tdaede/toshiba-64mbit-adapter/toshiba-64mbit-adapter.pdf

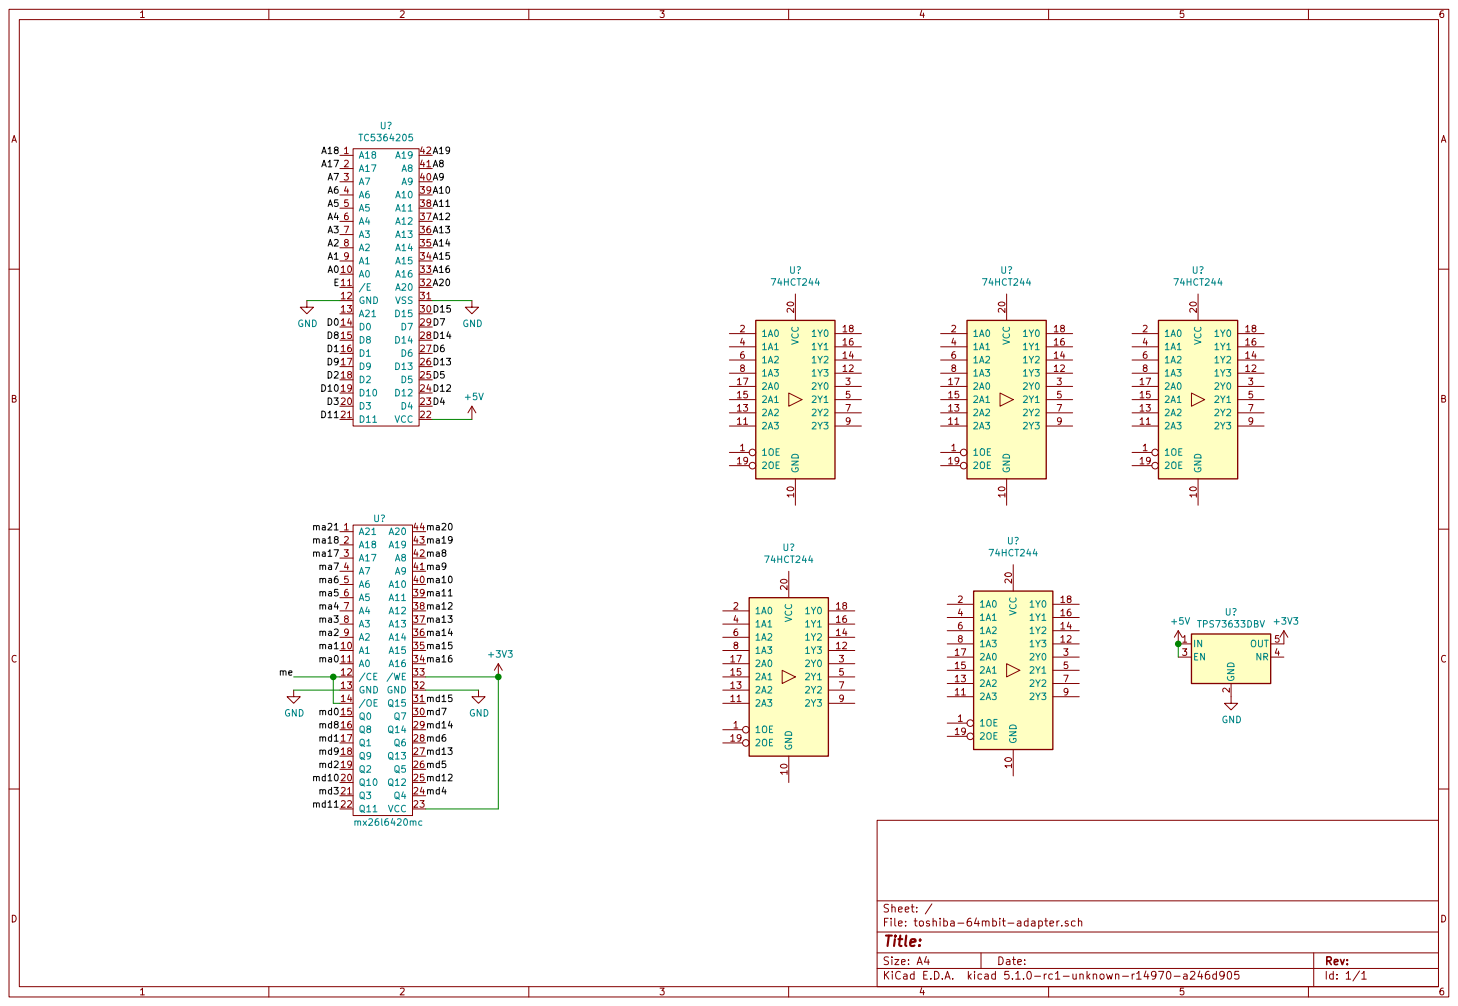
[picture p1: page 1]

File: toshiba-64mbit-adapter.sch Sheet: /
