tdaede/toshiba-64mbit-adapter/toshiba-64mbit-adapter.kicad_pcb

## KiCad design toshiba-64mbit-adapter.kicad_pcb (2019-04-03)

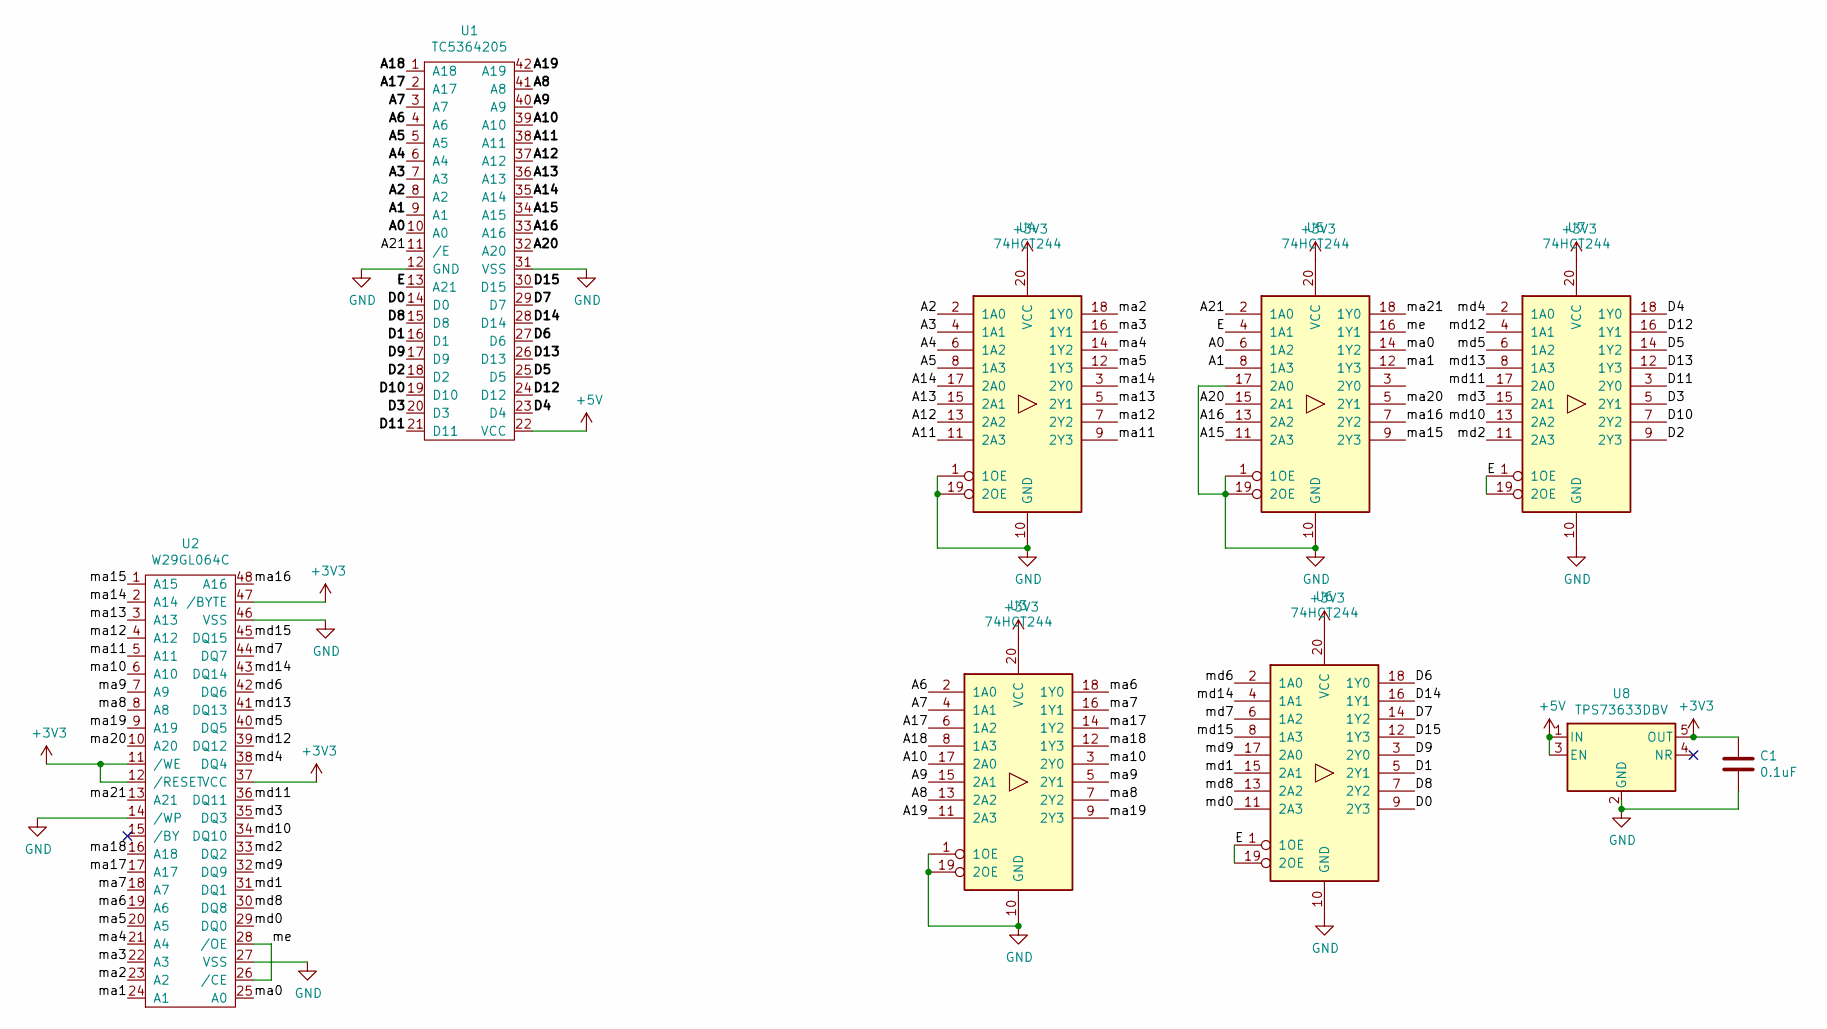
[picture p2: schematic toshiba-64mbit-adapter.sch]

Parts:
C1: 0.1uF; C_0805_2012Metric
U1: TC5364205; DIP-42_W15.24mm
U2: W29GL064C; TSOP-I-48_18.4x12mm_P0.5mm
U3, U4, U5, U6, U7: 74HCT244; TSSOP-20_4.4x6.5mm_P0.65mm
U8: TPS73633DBV; SOT-23-5

Connections:
+3V3: C1.2, U2.11 (/WE), U2.12 (/RESET), U2.37 (VCC), U2.47 (/BYTE), U3.20 (VCC), U4.20 (VCC), U5.20 (VCC), U6.20 (VCC), U7.20 (VCC), U8.5 (OUT)
+5V: U1.22 (VCC), U8.1 (IN), U8.3 (EN)
/A0: U1.10 (A0), U5.6 (1A2)
/A1: U1.9 (A1), U5.8 (1A3)
/A2: U1.8 (A2), U4.2 (1A0)
/A3: U1.7 (A3), U4.4 (1A1)
/A4: U1.6 (A4), U4.6 (1A2)
/A5: U1.5 (A5), U4.8 (1A3)
/A6: U1.4 (A6), U3.2 (1A0)
/A7: U1.3 (A7), U3.4 (1A1)
/A8: U1.41 (A8), U3.13 (2A2)
/A9: U1.40 (A9), U3.15 (2A1)
/A10: U1.39 (A10), U3.17 (2A0)
/A11: U1.38 (A11), U4.11 (2A3)
/A12: U1.37 (A12), U4.13 (2A2)
/A13: U1.36 (A13), U4.15 (2A1)
/A14: U1.35 (A14), U4.17 (2A0)
/A15: U1.34 (A15), U5.11 (2A3)
/A16: U1.33 (A16), U5.13 (2A2)
/A17: U1.2 (A17), U3.6 (1A2)
/A18: U1.1 (A18), U3.8 (1A3)
/A19: U1.42 (A19), U3.11 (2A3)
/A20: U1.32 (A20), U5.15 (2A1)
/A21: U1.11 (/E), U5.2 (1A0)
/D0: U1.14 (D0), U6.9 (2Y3)
/D1: U1.16 (D1), U6.5 (2Y1)
/D2: U1.18 (D2), U7.9 (2Y3)
/D3: U1.20 (D3), U7.5 (2Y1)
/D4: U1.23 (D4), U7.18 (1Y0)
/D5: U1.25 (D5), U7.14 (1Y2)
/D6: U1.27 (D6), U6.18 (1Y0)
/D7: U1.29 (D7), U6.14 (1Y2)
/D8: U1.15 (D8), U6.7 (2Y2)
/D9: U1.17 (D9), U6.3 (2Y0)
/D10: U1.19 (D10), U7.7 (2Y2)
/D11: U1.21 (D11), U7.3 (2Y0)
/D12: U1.24 (D12), U7.16 (1Y1)
/D13: U1.26 (D13), U7.12 (1Y3)
/D14: U1.28 (D14), U6.16 (1Y1)
/D15: U1.30 (D15), U6.12 (1Y3)
/E: U1.13 (A21), U5.4 (1A1), U6.1 (1OE), U6.19 (2OE), U7.1 (1OE), U7.19 (2OE)
/ma0: U2.25 (A0), U5.14 (1Y2)
/ma1: U2.24 (A1), U5.12 (1Y3)
/ma2: U2.23 (A2), U4.18 (1Y0)
/ma3: U2.22 (A3), U4.16 (1Y1)
/ma4: U2.21 (A4), U4.14 (1Y2)
/ma5: U2.20 (A5), U4.12 (1Y3)
/ma6: U2.19 (A6), U3.18 (1Y0)
/ma7: U2.18 (A7), U3.16 (1Y1)
/ma8: U2.8 (A8), U3.7 (2Y2)
/ma9: U2.7 (A9), U3.5 (2Y1)
/ma10: U2.6 (A10), U3.3 (2Y0)
/ma11: U2.5 (A11), U4.9 (2Y3)
/ma12: U2.4 (A12), U4.7 (2Y2)
/ma13: U2.3 (A13), U4.5 (2Y1)
/ma14: U2.2 (A14), U4.3 (2Y0)
/ma15: U2.1 (A15), U5.9 (2Y3)
/ma16: U2.48 (A16), U5.7 (2Y2)
/ma17: U2.17 (A17), U3.14 (1Y2)
/ma18: U2.16 (A18), U3.12 (1Y3)
/ma19: U2.9 (A19), U3.9 (2Y3)
/ma20: U2.10 (A20), U5.5 (2Y1)
/ma21: U2.13 (A21), U5.18 (1Y0)
/md0: U2.29 (DQ0), U6.11 (2A3)
/md1: U2.31 (DQ1), U6.15 (2A1)
/md2: U2.33 (DQ2), U7.11 (2A3)
/md3: U2.35 (DQ3), U7.15 (2A1)
/md4: U2.38 (DQ4), U7.2 (1A0)
/md5: U2.40 (DQ5), U7.6 (1A2)
/md6: U2.42 (DQ6), U6.2 (1A0)
/md7: U2.44 (DQ7), U6.6 (1A2)
/md8: U2.30 (DQ8), U6.13 (2A2)
/md9: U2.32 (DQ9), U6.17 (2A0)
/md10: U2.34 (DQ10), U7.13 (2A2)
/md11: U2.36 (DQ11), U7.17 (2A0)
/md12: U2.39 (DQ12), U7.4 (1A1)
/md13: U2.41 (DQ13), U7.8 (1A3)
/md14: U2.43 (DQ14), U6.4 (1A1)
/md15: U2.45 (DQ15), U6.8 (1A3)
/me: U2.26 (/CE), U2.28 (/OE), U5.16 (1Y1)
GND: C1.1, U1.12 (GND), U1.31 (VSS), U2.14 (/WP), U2.27 (VSS), U2.46 (VSS), U3.1 (1OE), U3.10 (GND), U3.19 (2OE), U4.1 (1OE), U4.10 (GND), U4.19 (2OE), U5.1 (1OE), U5.10 (GND), U5.17 (2A0), U5.19 (2OE), U6.10 (GND), U7.10 (GND), U8.2 (GND)

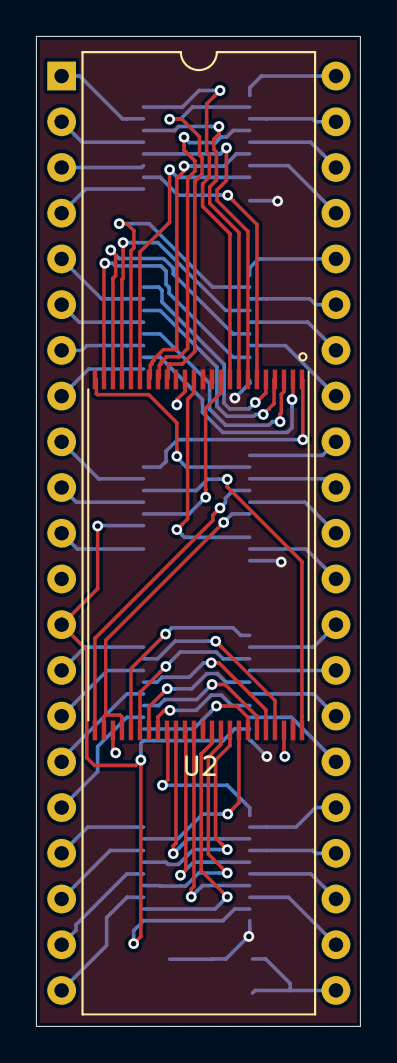
[picture p3: board toshiba-64mbit-adapter.kicad_pcb from above]

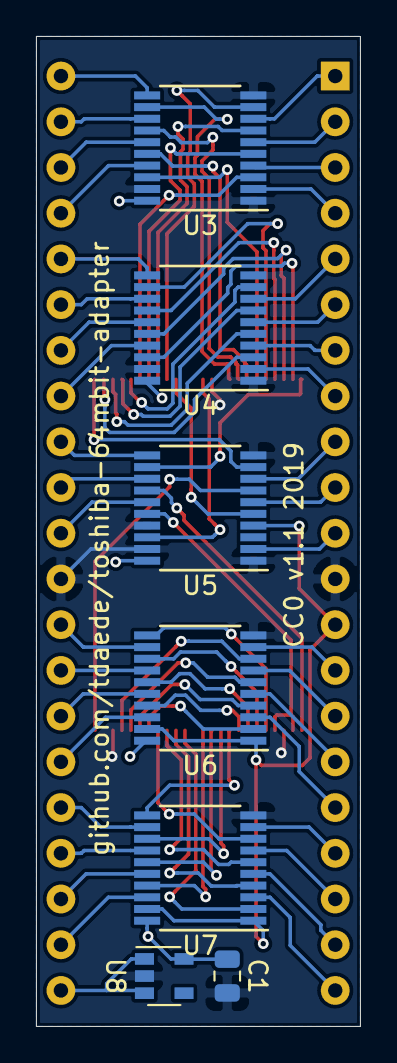
[picture p4: board toshiba-64mbit-adapter.kicad_pcb from below]

Board: 2 copper layers, 18.0 x 55.0 mm, 9 parts (7 on the bottom side), 81 nets.
