tdaede/toshiba-64mbit-adapter/(threads)

Thread 1 (2020-10-13):

Support for smaller flash and 8-bit mode

0x15e, 2020-10-13:
I was just taking a look at this as a possible solution for adapting 32Mbit flash to use for replacing V roms on MVS carts but it looks like it'll need some changes before that's possible. Ideally, I'd like to make it "universal" to some extent so that it supports 8, 16, and 32Mbit flash in either 8 or 16-bit mode.

I'm happy to submit a PR for this but was hoping you could help me with some questions first.

First, I can tell it's not intended to be a drop-in replacement for V roms because you have the BYTE pin held high, which forces 16-bit mode. Also, there's an unused bit on one of the level translators (U5 I think). Could it be possible that routing that pin through the level translator to the flash, or even making it configurable by solder jumper, is all that's necessary to make this adapter more universal?

Second, it looks like the level translators wouldn't be shifting the 3.3V logic out from the flash to the data pins, but instead just buffering it (because you're using 3.3V as Vcc on the buffers). Is that intentional and does it matter (and do I understand that right)?

Finally, what was the reasoning behind selecting the TTL level instead of CMOS level part for the level translators? From reading the datasheet it looks like it should be fine but the CMOS part might be a better fit for the voltage range.

Thanks!

Santabomber, 2020-10-14:
I was also thinking about this but realized that it might be better to maybe change the chip to a more readily availible one such as S29GL032N90TFI040 (tsop48) that mouser has for 1.6€. Availible in both 64/32Mb size and 8/16 bit mode.. Ill think ill have a look at the mvs scans of the never games and see what leveltranslators they use with these ones

0x15e, 2020-10-14:
That's actually the same / very close to the flash I have in mind. S29GL064N, S29GL032N, S29AL016J, and S29AL008J should all be interchangeable here as long as the BYTE and address pins are handled right. As far as I can tell, all the data pins are in the same places and they all behave the same way once written.

tdaede, 2020-10-14:
All of the buffer chips are actually populated with LVC, not HCT. I spun this adapter out real quick and didn't bother to fix the schematic. Also, really the output buffers should probably be HCT with 5V supply - I probably forgot to finish that part, but it's also not necessary for TTL inputs.

Yeah I didn't need BYTE. Just running the pin is enough if floating the high bits isn't necessary.

0x15e, 2020-11-17:
For anyone watching this, I haven't forgotten about it. I just ran into some unexpected challenges and spare time is a little harder to come by.

First, I went down a rabbit hole thinking I'd replace the buffers / translators with SN74LVC4245A chips, which are proper bus level translators. I ended up backtracking on this because, among other reasons, the part is larger and costs twice as much, and it would unnecessarily complicate the circuit.

After that I switched the inputs to LVC and outputs to HCT @ 5V.

Next I started looking at handling that BYTE pin. First off, the flash and mask rom handle it differently because the flash has more pins. The part numbers for the 32M mask roms in byte or word mode are different and the 64M just flat out doesn't support byte mode. I expect the reasoning for this is pretty simple: there aren't enough pins on that DIP42 packaging.

Additionally, for any of the chips that support byte mode, one of the data lines is bidirectional. That means that for byte mode, some solder jumpers will have to go one way but for word mode, they go the other.

My intent is to add 5 solder jumpers to allow for configuring the adapter:

- One that configures the flash for byte or word mode
- One that switches the signal going to/from pin 30 on U1 between D15 out (word mode) and A-1 in (byte mode)
- One that switches the signal going to/from pin 45 on U2 between md15 (word mode) and ma-1 (byte mode)
- One each for pulling A-1 and ma-1 down when the adapter is being used in word mode

I'd greatly appreciate any feedback on this as I haven't done very many projects like this. Everything should be visible already on [cadlab (in the vhc-hct-parts branch)](https://cadlab.io/project/23407/vhc-hct-parts/circuit/dG9zaGliYS02NG1iaXQtYWRhcHRlci5zY2g%3D) or in my clone [here](https://github.com/0x15e/toshiba-64mbit-adapter/tree/vhc-hct-parts). Don't bother spending time on the PCB yet as I haven't done any work there.

pizzzza19, 2025-02-23:
Hello
Is this project stiil on active?
I have Neogeo V-ROM broken down and need to replace with 27C322 32Mbit.
This is what i am looking for but not sure still in progress.
Many people trying to create 27C322 8bit adapter but never shown in public.
