tdaede/toshiba-64mbit-adapter/(notices)

Notices in the files:
toshiba-64mbit-adapter.kicad_pcb:
CC0 v1.1 2019
